MistyWest/VR-Gantry-Mechanical/README.md

# MECHANICAL - HTC Vive Gantry #





SolidWork 2015 design files for the VR Gantry project.

The repository is moved to https://bitbucket.org/mw_active/vr-gantry-mechanical
