MistyWest/VR-Gantry-Mechanical/RevD/MW05 BOM RevD.xlsx

Sheet: Sheet1
ITEM NO. | PART NUMBER | DESCRIPTION | FILE / CONF NAME | EXPAND | SUPPLIER | SUPPLIER PN | SUPPLIER MOQ | UNITS | SUPPLIER PRICE | QTY. | INCLUDED IN DRAWING | SUPPLIER LEAD TIME | QTY TO ORDER | TOTAL COST
1 | MW-MW05-C001 |  | MW-MW05-C001 | CONSTRUCTION |  |  |  |  |  | 1
3 | MW-MW05-P009 | Y GANTRY WHEEL BRACKET | MW-MW05-P009 | BUILD |  |  |  |  |  | 2 | x |  | 2 | $0.00
4 | MW-MW05-P010 | Y GANTRY TOP PLATE W/ CABLE MOUNT | MW-MW05-P010 | BUILD |  |  |  |  |  | 1 | x |  | 1 | $0.00
8 | MW-MW05-P015 | Y GANTRY FRAMING BRACKET | MW-MW05-P015 | BUILD |  |  |  |  |  | 4 | x |  | 4 | $0.00
10 | MW-MW05-P022 | Y GANTRY WHEEL MOUNT RECTANGULAR WASHER | MW-MW05-P022 | BUILD |  |  |  |  |  | 4 | x |  | 4 | $0.00
11 | MW-MW05-P010 | Y GANTRY TOP PLATE | MW-MW05-P010 | BUILD |  |  |  |  |  | 1 | x |  | 1 | $0.00
13 | MW-MW05-P014 | X GANTRY WHEEL BRACKET | MW-MW05-P014 | BUILD |  |  |  |  |  | 1 | x |  | 1 | $0.00
14 | MW-MW05-P011 | X GANTRY TOP PLATE | MW-MW05-P011 | BUILD |  |  |  |  |  | 1 | x |  | 1 | $0.00
16 | MW-MW05-P023 | X GANTRY FRAME BRACKET | MW-MW05-P023 | BUILD |  |  |  |  |  | 2 | x |  | 2 | $0.00
19 | MW-MW05-P007 | STEPPER MOTOR BRACKET | MW-MW05-P007 | BUILD |  |  |  |  |  | 2 | x |  | 2 | $0.00
20 | MW-MW05-P008 | UPPER PULLEY BRACKET | MW-MW05-P008 | BUILD |  |  |  |  |  | 2 | x |  | 2 | $0.00
29 | MW-MW05-P019 | LASER CUT SPACER | MW-MW05-P019 | BUILD |  |  |  |  |  | 2 | x |  | 2 | $0.00
31 | MW-MW05-P021 | Y CABLE GUIDE MOUNT | MW-MW05-P021 | BUILD |  |  |  |  |  | 1 | x |  | 1 | $95.00 | Price from Bombay Engraving
22 | 1254N22_MXL LIGHTWEIGHT TIMING BELT PULLEY 0.693IN OD 0.25IN WD |  | 1254N22_MXL LIGHTWEIGHT TIMING BELT PULLEY 0.693IN OD 0.25IN WD | BUY | MCMASTER-CARR | 1254N22 |  | EA | $6.50 | 8 |  |  | 8 | $52.00
27 | 1688K500_ULTRA-LOW-FRICTION OIL- EMBEDDED SLEEVE BRNG |  | 1688K5 | BUY | MCMASTER-CARR | 1688K500 |  | EA | $0.74 | 2 |  |  | 2 | $1.48
25 | 3088A464_STEEL SHIM 0.062IN THICK |  | 3088A464_STEEL SHIM 0.062IN THICK | BUY | MCMASTER-CARR | 3088A464 | 1 | PK10 | $5.05 | 6 |  |  | 1 | $5.05
18 | 4409T243_SNAP-TOGETHER CABLE AND HOSE CARRIER | Snap-Together Cable and Hose Carrier for 0.3" Maximum Cable OD/0.6" Total Cable Width, Open | 4409T243 | BUY | MCMASTER-CARR | 4409T243 | 1, 3, 6 FT | PER FT | $15.98 | 2 |  |  | 12 | $191.76
9 | 4556T340_MOUNTING BRACKET | Mounting Brackets for 0.6" High x 1.1" Wide Open Snap-Together Cable and Hose Carrier | 4556T340_MOUNTING BRACKET | BUY | MCMASTER-CARR | 4556T340 |  | PK2 | $9.21 | 4 |  |  | 2 | $18.42
17 | 47065T236_ALUMINUM T-SLOTTED FRAMING EXTRUSION | Bracket, 1" Long for 1" High Single Profile Aluminum T-Slotted Framing Extrusion | 47065T236 | BUY | MCMASTER-CARR | 47065T236 |  | EA | $5.79 | 4 |  |  | 4 | $23.16
36 | 47065T239_ALUMINUM T-SLOTTED FRAMING EXTRUSION | Bracket, 2" Long for 1" High Single Profile Aluminum T-Slotted Framing Extrusion | 47065T239 | BUY | MCMASTER-CARR | 47065T239 |  | EA | $5.85 | 4 |  |  | 4 | $23.40
21 | 47065T970_ALUMINUM T-SLOTTED FRAMING EXTRUSION | Steel End-Feed Fastener for 1-1/2" Single/3" Quad Aluminum T-Slotted Framing Extrusion | 47065T97 | BUY | MCMASTER-CARR | 47065T970 |  | PK4 | $2.71 | 27 |  |  | 9 | $24.39
32 | 7959K21_MXL TIMING BELT | 1/4" Width Mxl Series Timing Belt | 7959K21_MXL TIMING BELT | BUY | MCMASTER-CARR | 7959K21 |  | PER FT | $2.16 | 1 |  |  | 48 | $103.68
26 | 90633A011_LOW-STRENGTH STEEL THIN NYLON- INSERT LOCKNUT |  | 90633A011 | BUY | MCMASTER-CARR | 90633A011 |  | PK100 | $3.14 | 8 |  |  | 1 | $3.14
5 | 91290A164_BLACK-OXIDE CLASS 12.9 SHCS M4x16MM | Black-Oxide Class 12.9 Socket Head Cap Screw, Alloy Steel, M4 Thread, 18mm Length, 0.70mm Pitch | 91290A150 | BUY | MCMASTER-CARR | 91290A164 |  | PK100 | $10.98 | 26 |  |  | 1 | $10.98
24 | 92510A483_ALUM UNTHRD SPACER | 5/8" OD, 1/8" Length, for 1/4" Screw Size | 92510A483 | BUY | MCMASTER-CARR | 92510A483 |  | EA | $1.71 | 18 |  |  | 1 | $1.71
28 | 93268A501_BRASS SHIM 0.001IN |  | 93268A501_BRASS SHIM 0.001IN | BUY | MCMASTER-CARR | 93268A501 |  | PK10 | $8.64 | 4 |  |  | 1 | $8.64
23 | 94035A578_TIGHT-TOLERANCE SOCKET DRIVE SHOULDER SCREW |  | 94035A578 | BUY | MCMASTER-CARR | 94035A578 | 5 | EA | $4.57 | 8 |  |  | 8 | $36.56
6 | 96887A329_CLASS 5 STEEL SQUARE NUT | Class 5 Steel Square Nut, Zinc Plated, M4x0.7 Thread Size, 7mm Wide, 3.2mm High | 96887A329 | BUY | MCMASTER-CARR | 96887A329 |  | PK100 | $10.00 | 26 |  |  | 1 | $10.00
15 | 9904K100_TRACK ROLLER CARRIAGE FOR T- SLOTTED FRAMING | Track Roller Carriage for T-Slotted Framing for 1/4" Width T-Slot, 1" High Rail | 9904K1 | BUY | MCMASTER-CARR | 9904K100 |  | EA | $56.67 | 6 |  |  | 6 | $340.02
12 | MW-MW05-P006 | Aluminum T-Slotted Framing Extrusion, Single Profile, 1" Size, Solid, 4' Long | MW-MW05-P006 | BUY | MCMASTER-CARR | 47065T122 |  | EA | $19.79 | 5 |  |  | 5 | $98.95
34 | PP-ARDUINO |  |  | BUY |  |  |  | EA | $20.00 | 1 |  | http://openbuildspartstore.com/cnc-xpro-v2- controller-stepper-driver/ | 1 | $20.00
33 | PP-MICRO LIMIT SWITCH | Micro Limit Switch Kit with Mounting Plate | PP-MICRO LIMIT SWITCH | BUY | OPENBUILDS | SKU 745 |  | EA | $2.50 | 4 |  | http://openbuildspartstore.com/micro-limit- switch-kit-with-mounting-plate/ | 4 | $10.00
30 | PP-NEMA 23 | NEMA 23 Shaft Size: 1/4" Torque: 175 oz-in 2.8A 12-48V 4-wire Bipolar | Nema 23 Stepper Motor | BUY | OPENBUILDS | SKU518 |  | EA | $31.92 | 2 |  | http://openbuildspartstore.com/nema-23- stepper-motor/ | 2 | $63.84
36 | PP-STEPPER DRIVER |  |  | BUY | OPENBUILDS |  |  | EA | $52.00 | 2 |  |  | 2 | $104.00
35 | PP-TIMING BELT TORSION SPRING | Timing Belt Tension Torsion Spring | PP-TIMING BELT TORSION SPRING | BUY | OPENBUILDS | SKU 75 |  | EA | $1.04 | 4 |  | http://openbuildspartstore.com/timing-belt- tension-torsion-spring/ | 4 | $4.16
 |  |  |  |  |  |  |  |  |  |  |  |  | TOTAL | $1250.34

Sheet: Sheet2
SUPPLIER PN | QTY TO ORDER
1254N22 | 8
1688K500 | 2
3088A464 | 1
4409T243 | 12
4556T340 | 2
47065T236 | 4
47065T239 | 4
47065T970 | 9
7959K21 | 35
90633A011 | 1
91290A164 | 1
92510A483 | 1
93268A501 | 1
94035A578 | 8
96887A329 | 1
9904K100 | 2
9904K300 | 4
47065T146 | 4
47065T121 | 1
8505K92 | 1
SKU 885 | 1
SKU 745 | 4
SKU518 | 2
SKU 75 | 4
