MistyWest/VR-Gantry-Mechanical/RevD/MW-MW05-A008.SLDASM

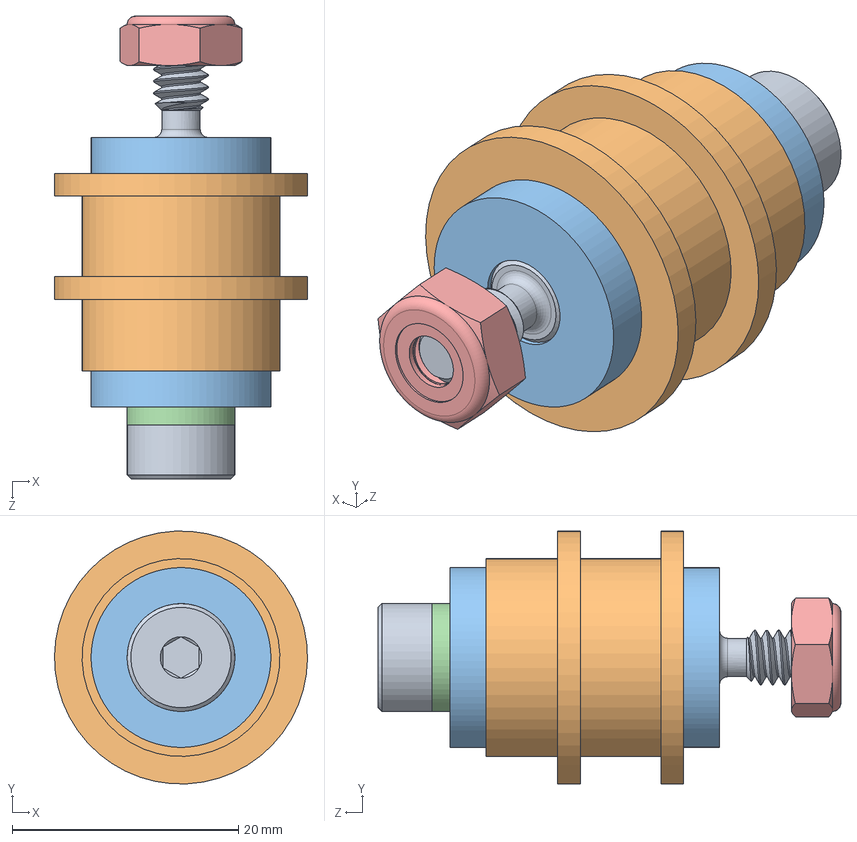
[picture p1: CAD file, 2017-03-31]
RevD/MW-MW05-A008.SLDASM
22.4 x 22.3 x 40.9 mm
94035A578_TIGHT-TOLERANCE SOCKET DRIVE SHOULDER SCREW
1254N22_MXL LIGHTWEIGHT TIMING BELT PULLEY 0.693IN OD 0.25IN WD
92510A483_ALUM UNTHRD SPACER x 2
3088A464_STEEL SHIM 0.062IN THICK
90633A011_LOW-STRENGTH STEEL THIN NYLON-INSERT LOCKNUT
