MistyWest/VR-Gantry-Mechanical/RevD/MW-MW05-A005.SLDASM

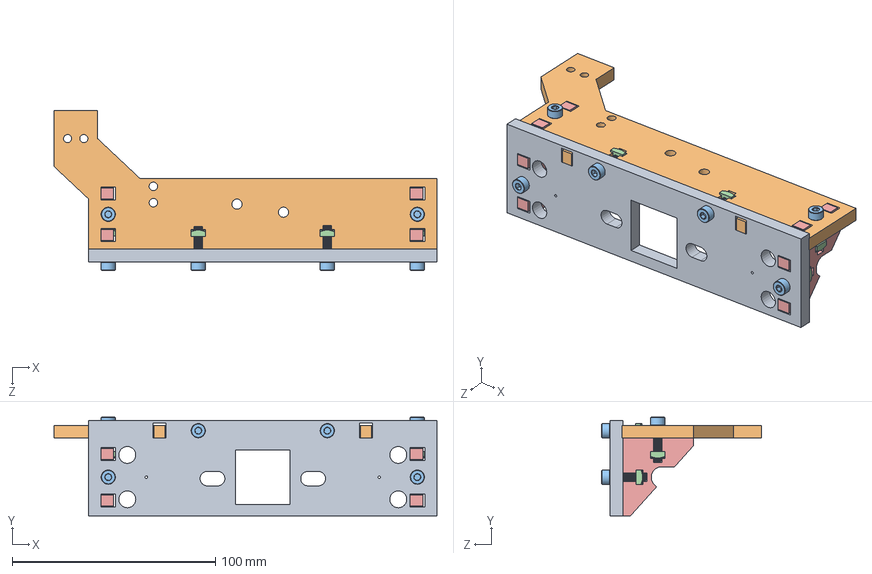
[picture p2: CAD file, 2017-03-31]
RevD/MW-MW05-A005.SLDASM
188.5 x 48.6 x 78.5 mm
MW-MW05-P009
MW-MW05-P010
91290A154_BLACK-OXIDE CLASS 12.9 SHCS M4x16MM x 6
96887A329_CLASS 5 STEEL SQUARE NUT x 6
MW-MW05-P015 x 2
