MistyWest/VR-Gantry-Mechanical/RevD/MW-MW05-A006.SLDASM

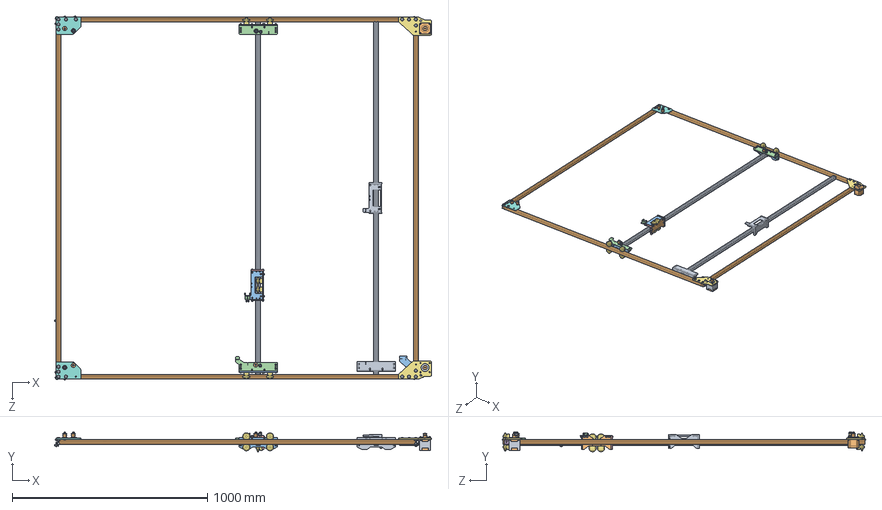
[picture p3: CAD file, 2017-03-31]
RevD/MW-MW05-A006.SLDASM
1929.8 x 100.5 x 1862.8 mm
MW-MW05-P005
MW-MW05-P009 x 2
MW-MW05-P010 x 2
91290A154_BLACK-OXIDE CLASS 12.9 SHCS M4x16MM x 26
96887A329_CLASS 5 STEEL SQUARE NUT x 26
9904K100_TRACK ROLLER CARRIAGE FOR T-SLOTTED FRAMING x 6
MW-MW05-P015 x 4
MW-MW05-P006
MW-MW05-P014
MW-MW05-P011
MW-MW05-P023 x 2
47065T236_ALUMINUM T-SLOTTED FRAMING EXTRUSION x 4
MW-MW05-P007 x 2
MW-MW05-P008 x 2
47065T970_ALUMINUM T-SLOTTED FRAMING EXTRUSION x 20
1254N22_MXL LIGHTWEIGHT TIMING BELT PULLEY 0.693IN OD 0.25IN WD x 8
94035A578_TIGHT-TOLERANCE SOCKET DRIVE SHOULDER SCREW x 8
92510A483_ALUM UNTHRD SPACER x 18
3088A464_STEEL SHIM 0.062IN THICK x 6
90633A011_LOW-STRENGTH STEEL THIN NYLON-INSERT LOCKNUT x 7
1688K500_ULTRA-LOW-FRICTION OIL-EMBEDDED SLEEVE BRNG x 2
93268A501_BRASS SHIM 0.001IN x 4
MW-MW05-P019 x 2
Nema 23 Stepper Motor x 2
MW-MW05-P021
47065T139_ALUMINUM T-SLOTTED FRAMING EXTRUSION x 3
97763A265_BLACK-OXIDE 18-8 SS BUTTON-HEAD CAP SCREW x 5
90494A029_LOW-STRENGTH STEEL THIN HEX NUT
