MistyWest/VR-Gantry-Mechanical/RevD/MW-MW05-A009.SLDASM

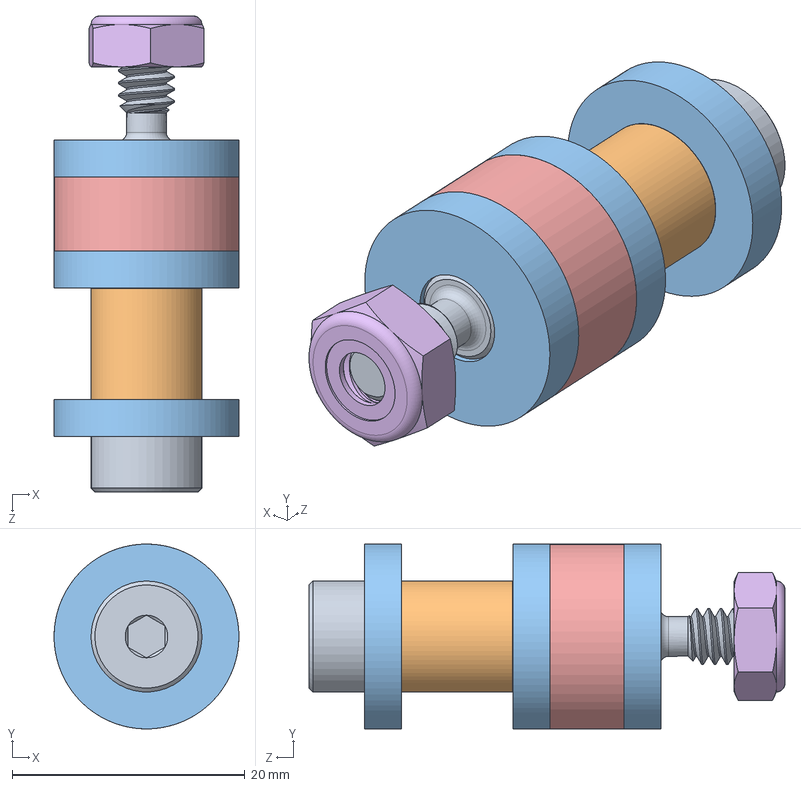
[picture p4: CAD file, 2017-03-31]
RevD/MW-MW05-A009.SLDASM
15.9 x 15.9 x 40.9 mm
94035A578_TIGHT-TOLERANCE SOCKET DRIVE SHOULDER SCREW
1688K500_ULTRA-LOW-FRICTION OIL-EMBEDDED SLEEVE BRNG
92510A483_ALUM UNTHRD SPACER x 3
93268A501_BRASS SHIM 0.001IN x 2
MW-MW05-P019
90633A011_LOW-STRENGTH STEEL THIN NYLON-INSERT LOCKNUT
