MistyWest/VR-Gantry-Mechanical/RevD/MW-MW05-A007.SLDASM

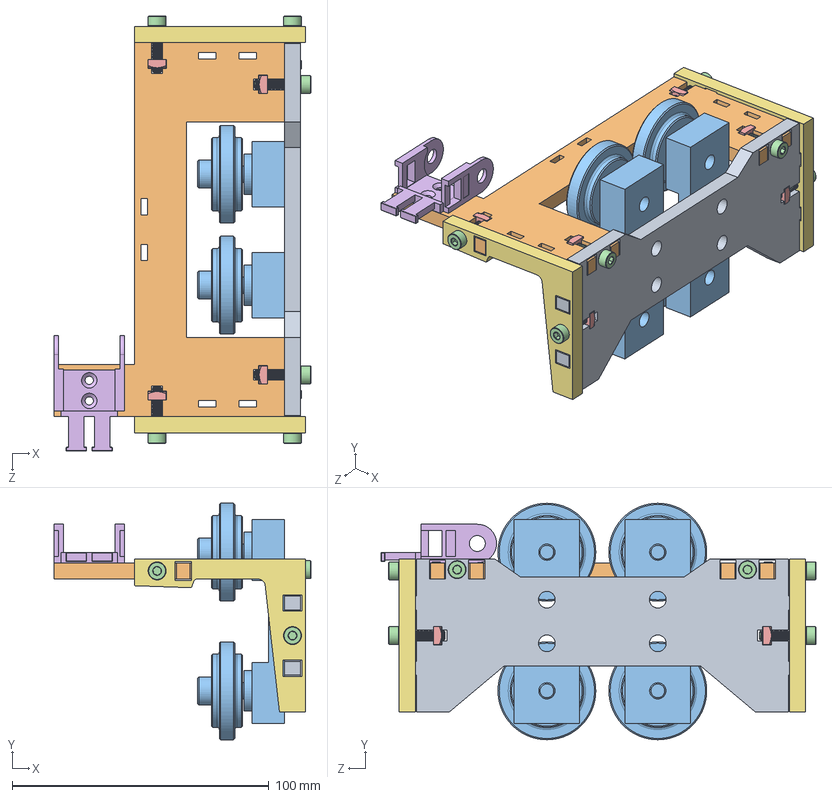
[picture p5: CAD file, 2017-03-31]
RevD/MW-MW05-A007.SLDASM
100.0 x 92.1 x 169.3 mm
MW-MW05-P014
MW-MW05-P011
9904K100_TRACK ROLLER CARRIAGE FOR T-SLOTTED FRAMING x 2
91290A154_BLACK-OXIDE CLASS 12.9 SHCS M4x16MM x 6
96887A329_CLASS 5 STEEL SQUARE NUT x 6
4556T340_MOUNTING BRACKET
MW-MW05-P023 x 2
