MistyWest/VR-Gantry-Mechanical/RevD/MW-MW05-P010.SLDPRT

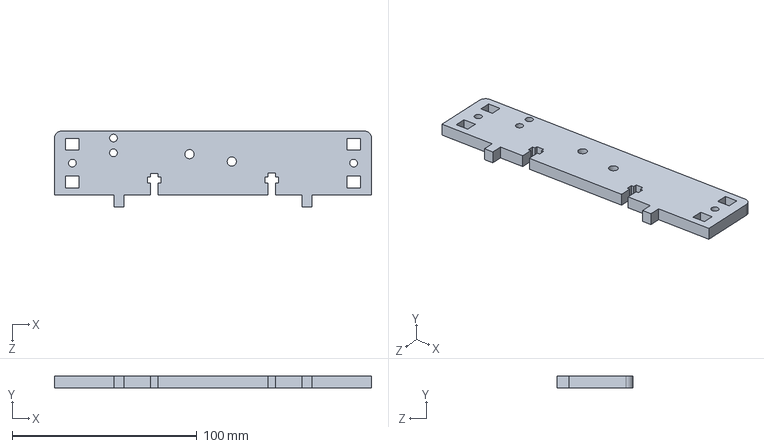
[picture p6: CAD file, 2017-03-31]
RevD/MW-MW05-P010.SLDPRT
171.5 x 6.35 x 41.1 mm
