MistyWest/VR-Gantry-Mechanical/RevD/MW-MW05-C001.SLDPRT

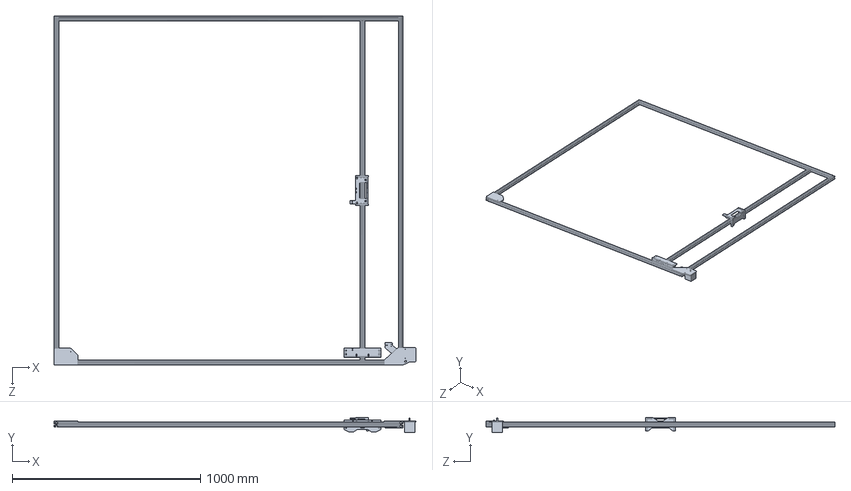
[picture p7: CAD file, 2017-03-31]
RevD/MW-MW05-C001.SLDPRT
1921.8 x 81.4 x 1854.2 mm
