MistyWest/VR-Gantry-Mechanical/RevD/MW-MW05-P007.SLDPRT

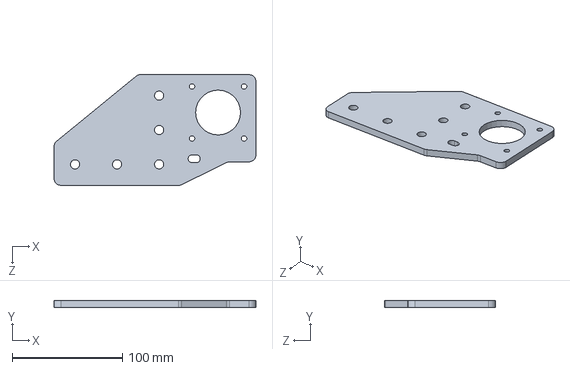
[picture p8: CAD file, 2017-03-31]
RevD/MW-MW05-P007.SLDPRT
183.0 x 6.35 x 100.4 mm
