MistyWest/VR-Gantry-Mechanical/RevD/MW-MW05-P008.SLDPRT

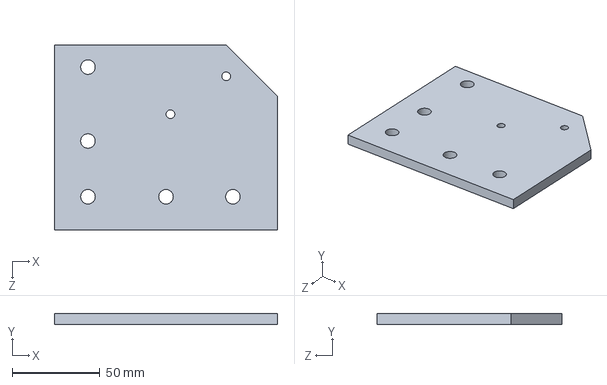
[picture p9: CAD file, 2017-03-31]
RevD/MW-MW05-P008.SLDPRT
127.0 x 6.35 x 105.6 mm
