MistyWest/VR-Gantry-Mechanical/RevD/MW-MW05-P019.SLDPRT

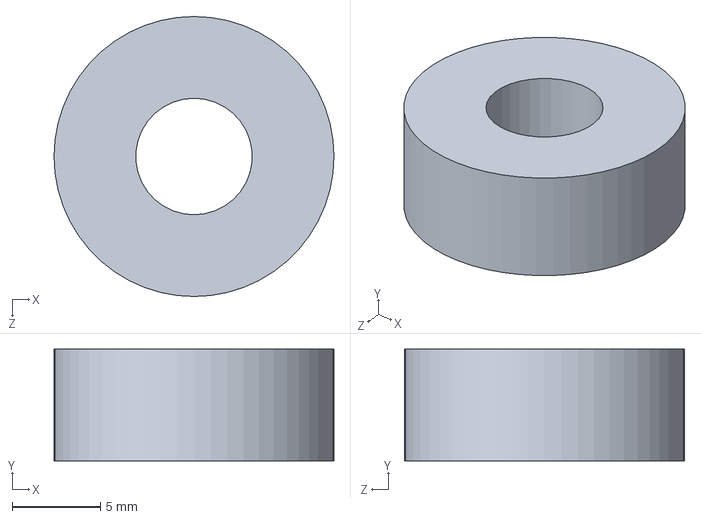
[picture p10: CAD file, 2017-03-31]
RevD/MW-MW05-P019.SLDPRT
15.9 x 6.35 x 15.9 mm
