MistyWest/VR-Gantry-Mechanical/RevD/MW-MW05-P015.SLDPRT

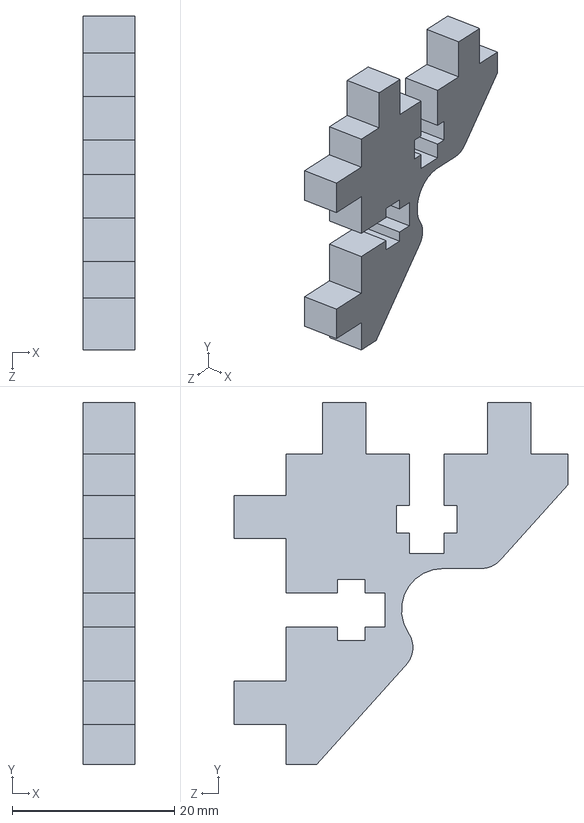
[picture p11: CAD file, 2017-03-31]
RevD/MW-MW05-P015.SLDPRT
6.35 x 44.6 x 41.1 mm
