MistyWest/VR-Gantry-Mechanical/RevD/2016.08.11_MW-MW05 Laser Cutouts.DXF

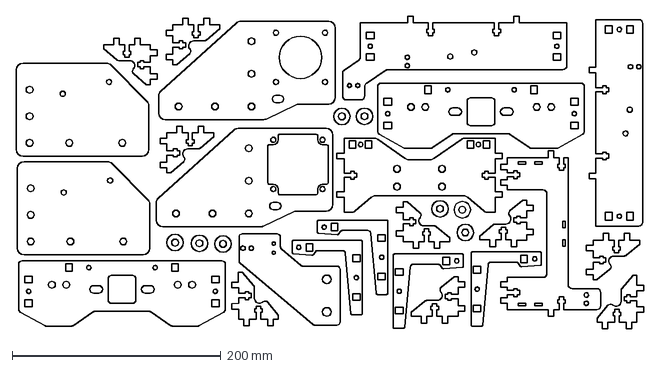
[picture p12: CAD file, 2017-03-31]
RevD/2016.08.11_MW-MW05 Laser Cutouts.DXF
601.5 x 299.8 mm
