MistyWest/VR-Gantry-Mechanical/RevD/MW-MW05-P009.SLDPRT

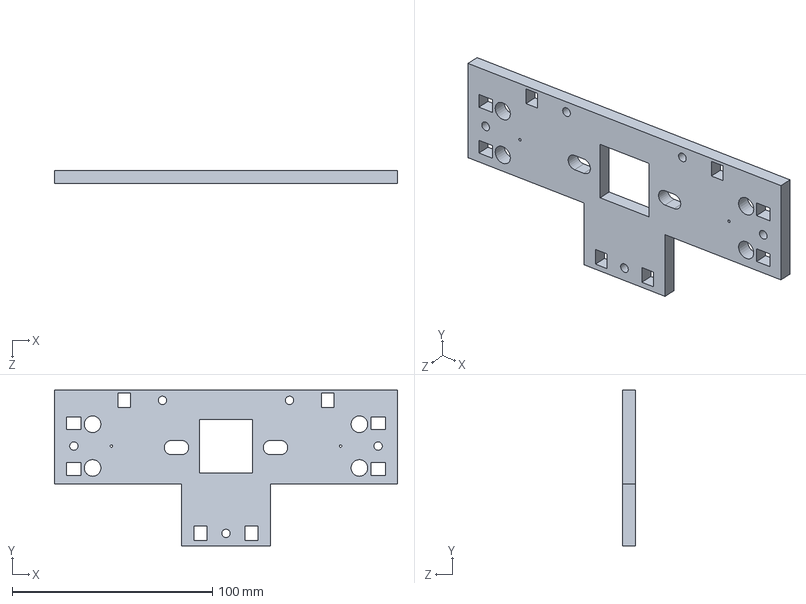
[picture p13: CAD file, 2017-03-31]
RevD/MW-MW05-P009.SLDPRT
171.4 x 77.8 x 6.35 mm
