MistyWest/VR-Gantry-Mechanical/RevD/MW-MW05-P021.SLDPRT

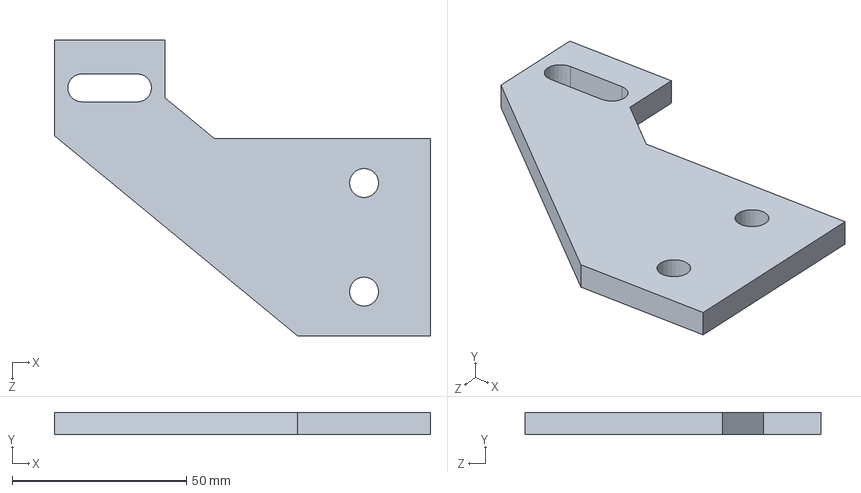
[picture p14: CAD file, 2017-03-31]
RevD/MW-MW05-P021.SLDPRT
107.8 x 6.35 x 84.8 mm
