MistyWest/VR-Gantry-Mechanical/RevD/MW-MW05-P005.SLDPRT

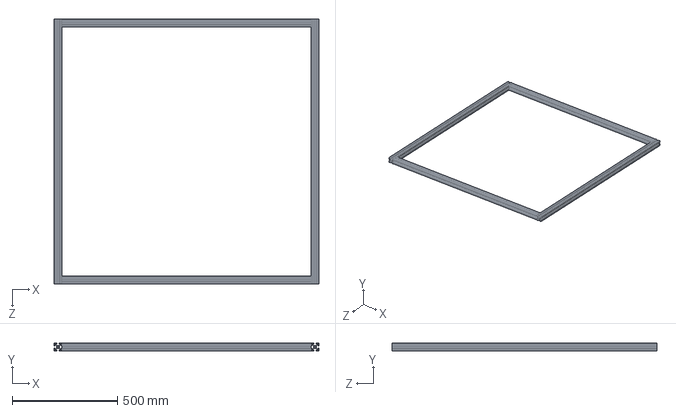
[picture p15: CAD file, 2017-03-31]
RevD/MW-MW05-P005.SLDPRT
1257.3 x 38.1 x 1257.3 mm
