MistyWest/VR-Gantry-Mechanical/RevD/MW-MW05-P011.SLDPRT

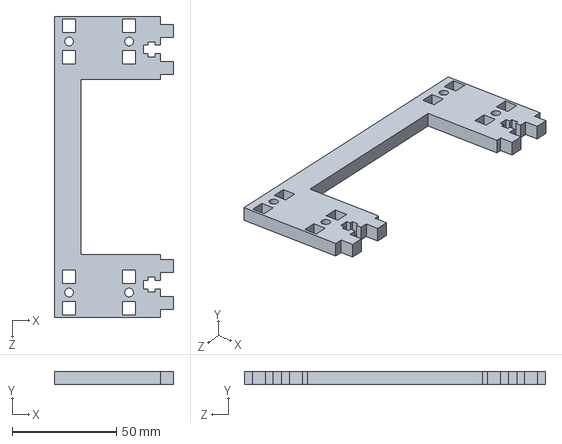
[picture p16: CAD file, 2017-03-31]
RevD/MW-MW05-P011.SLDPRT
57.2 x 6.35 x 144.8 mm
