MistyWest/VR-Gantry-Mechanical/RevD/MW-MW05-P022.SLDPRT

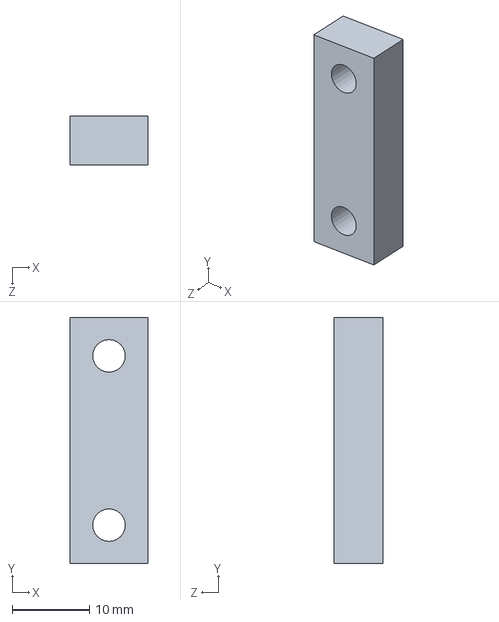
[picture p17: CAD file, 2017-03-31]
RevD/MW-MW05-P022.SLDPRT
10.1 x 31.8 x 6.35 mm
