MistyWest/VR-Gantry-Mechanical/RevD/Nema 23 Stepper Motor.SLDPRT

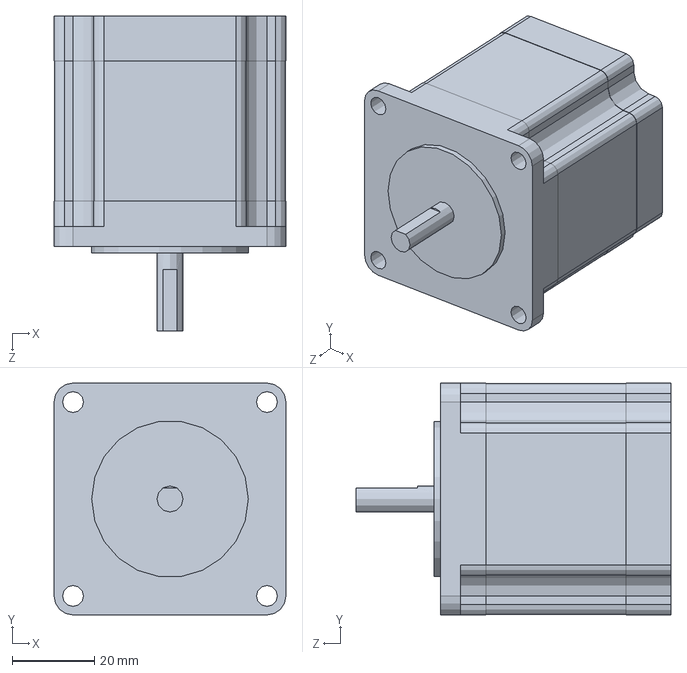
[picture p18: CAD file, 2017-03-31]
RevD/Nema 23 Stepper Motor.SLDPRT
56.4 x 56.4 x 76.6 mm
