MistyWest/VR-Gantry-Mechanical/RevD/MW-MW05-P006.SLDPRT

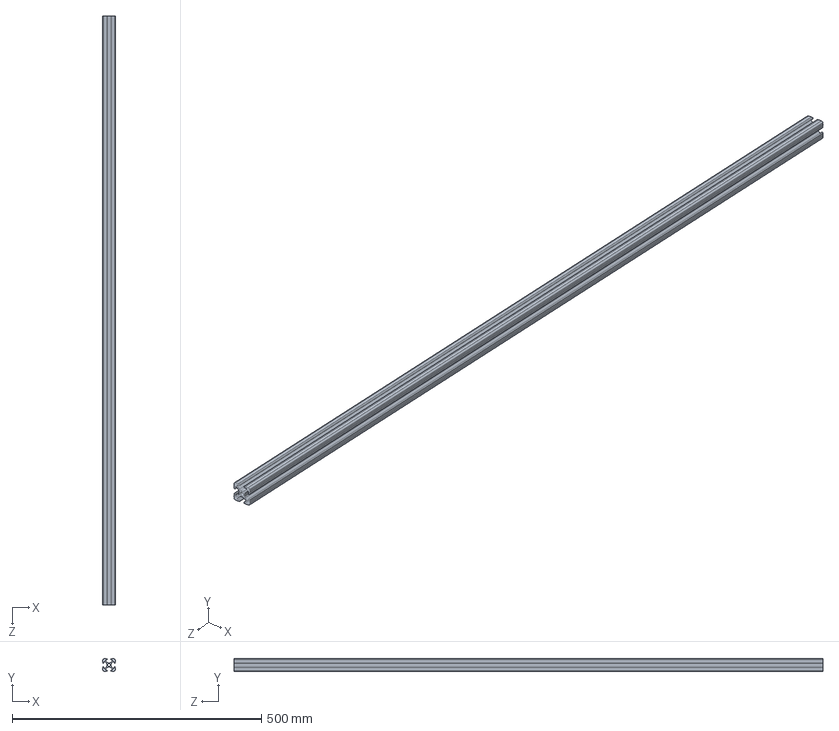
[picture p19: CAD file, 2017-03-31]
RevD/MW-MW05-P006.SLDPRT
25.4 x 25.4 x 1181.1 mm
