MistyWest/VR-Gantry-Mechanical/RevD/MW-MW05-P014.SLDPRT

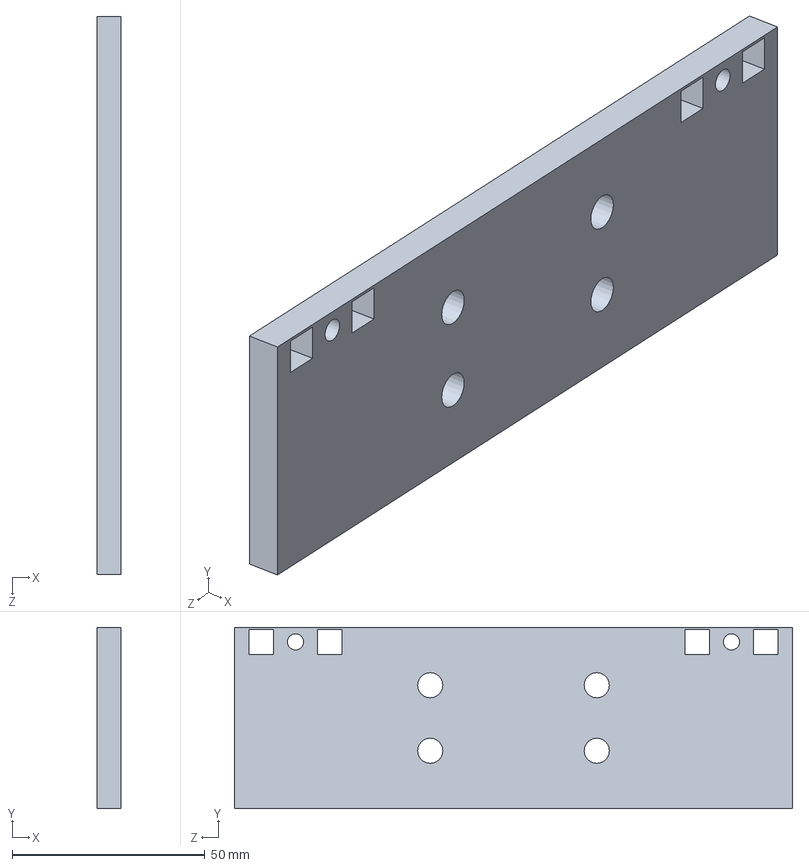
[picture p20: CAD file, 2017-03-31]
RevD/MW-MW05-P014.SLDPRT
6.35 x 46.9 x 144.8 mm
