MistyWest/VR-Gantry-Mechanical/RevD/MW-MW05-P023.SLDPRT

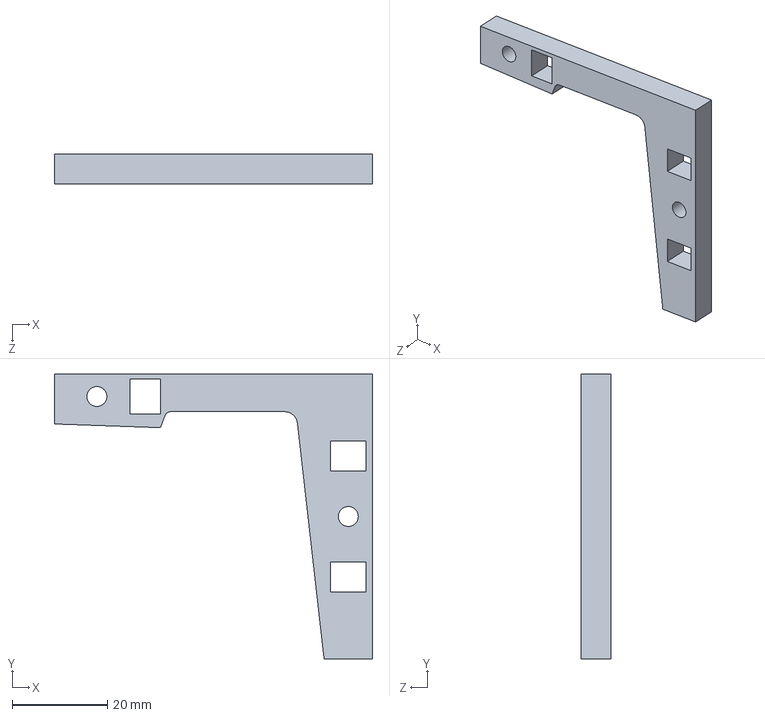
[picture p21: CAD file, 2017-03-31]
RevD/MW-MW05-P023.SLDPRT
66.7 x 59.7 x 6.35 mm
