MistyWest/VR-Gantry-Mechanical/(list of files, cad)

Other CAD files:
RevD/PP-CNC XPRO CONTROLLER STEPPER DRIVER.SLDPRT
RevD/PP-ACRYLIC SHEET 12X24IN.SLDPRT
RevD/PP-TIMING BELT TORSION SPRING.SLDPRT
RevD/PP-MICRO LIMIT SWITCH.SLDPRT
Archive/Human Reference/Calf.SLDPRT
Archive/Human Reference/Chest.SLDPRT
Archive/Human Reference/Foot.SLDPRT
Archive/Human Reference/Hand.SLDPRT
Archive/Human Reference/Head.SLDPRT
Archive/Human Reference/Human Body Model - Simple.SLDASM
Archive/Human Reference/LowerArm.SLDPRT
Archive/Human Reference/Thigh.SLDPRT
Archive/Human Reference/UpperArm.SLDPRT
Archive/Human Reference/neck.SLDPRT
Archive/Rev0/1254N22_MXL LIGHTWEIGHT TIMING BELT PULLEY 0.693IN OD 0.25IN WD.SLDPRT
Archive/Rev0/47065T236_ALUMINUM T-SLOTTED FRAMING EXTRUSION.SLDPRT
Archive/Rev0/47065T239_ALUMINUM T-SLOTTED FRAMING EXTRUSION.SLDPRT
Archive/Rev0/47065T970_ALUMINUM T-SLOTTED FRAMING EXTRUSION.SLDPRT
Archive/Rev0/60585K810_LINEAR BEARING FOR T-SLOTTED FRAMING.SLDPRT
Archive/Rev0/91290A154_BLACK-OXIDE CLASS 12.9 SHCS M4x16MM.SLDPRT
Archive/Rev0/93268A501_BRASS SHIM 0.001IN.SLDPRT
Archive/Rev0/96887A329_CLASS 5 STEEL SQUARE NUT.SLDPRT
Archive/Rev0/9904K100_TRACK ROLLER CARRIAGE FOR T-SLOTTED FRAMING.SLDPRT
Archive/Rev0/9904K300_TRACK ROLLER CARRIAGE FOR T-SLOTTED FRAMING.SLDPRT
Archive/Rev0/Assem3.SLDASM
Archive/Rev0/MW-MW05-A001.SLDASM
Archive/Rev0/MW-MW05-A002.SLDASM
Archive/Rev0/MW-MW05-A003.SLDASM
Archive/Rev0/MW-MW05-A004.SLDASM
Archive/Rev0/MW-MW05-A005.SLDASM
Archive/Rev0/MW-MW05-A006.SLDASM
Archive/Rev0/MW-MW05-A007.SLDASM
Archive/Rev0/MW-MW05-A008.SLDASM
Archive/Rev0/MW-MW05-A009.SLDASM
Archive/Rev0/MW-MW05-C001.SLDPRT
Archive/Rev0/MW-MW05-P001.SLDPRT
Archive/Rev0/MW-MW05-P002.SLDPRT
Archive/Rev0/MW-MW05-P003.SLDPRT
Archive/Rev0/MW-MW05-P004.SLDPRT
Archive/Rev0/MW-MW05-P005.SLDPRT
Archive/Rev0/MW-MW05-P006.SLDPRT
Archive/Rev0/MW-MW05-P007.SLDPRT
Archive/Rev0/MW-MW05-P008.SLDPRT
Archive/Rev0/MW-MW05-P009.SLDPRT
Archive/Rev0/MW-MW05-P010.SLDPRT
Archive/Rev0/MW-MW05-P011.SLDPRT
Archive/Rev0/MW-MW05-P012.SLDPRT
Archive/Rev0/MW-MW05-P013.SLDPRT
Archive/Rev0/MW-MW05-P014.SLDPRT
Archive/Rev0/MW-MW05-P015.SLDPRT
Archive/Rev0/MW-MW05-P016.SLDPRT
Archive/Rev0/MW-MW05-P017.SLDPRT
Archive/Rev0/MW-MW05-P018.SLDPRT
Archive/Rev0/MW-MW05-P019.SLDPRT
Archive/Rev0/NEMA23.SLDPRT
Archive/Rev0/Nema 23 Stepper Motor.SLDPRT
Archive/Rev0/PP-NEMA 23 STEPPER MOTOR.SLDPRT
Archive/Rev0/Play Area Layout.SLDPRT
Archive/Stepper Motor/Base.SLDPRT
Archive/Stepper Motor/Cuerpo.SLDPRT
Archive/Stepper Motor/Eje.SLDPRT
Archive/Stepper Motor/NEMA 17 with T5 Pulley.SLDASM
Archive/Stepper Motor/NEMA 17 with T5 Pulley.STEP
Archive/Stepper Motor/NEMA 17 with T5 Pulley.STP
Archive/Stepper Motor/NEMA 17.SLDASM
Archive/Stepper Motor/NEMA 17.STL
Archive/Stepper Motor/Tapa.SLDPRT
RevA/1254N22_MXL LIGHTWEIGHT TIMING BELT PULLEY 0.693IN OD 0.25IN WD.SLDPRT
RevA/1688K500_ULTRA-LOW-FRICTION OIL-EMBEDDED SLEEVE BRNG.SLDPRT
RevA/3088A464_STEEL SHIM 0.062IN THICK.SLDPRT
RevA/4409T243_SNAP-TOGETHER CABLE AND HOSE CARRIER.SLDPRT
RevA/4556T340_MOUNTING BRACKET.SLDPRT
RevA/47065T236_ALUMINUM T-SLOTTED FRAMING EXTRUSION.SLDPRT
RevA/47065T970_ALUMINUM T-SLOTTED FRAMING EXTRUSION.SLDPRT
RevA/7959K21_MXL TIMING BELT.SLDPRT
RevA/90633A011_LOW-STRENGTH STEEL THIN NYLON-INSERT LOCKNUT.SLDPRT
RevA/91290A154_BLACK-OXIDE CLASS 12.9 SHCS M4x16MM.SLDPRT
RevA/92137A303_CLASS 10.9 ALLOY STEEL BUTTON-HEAD CAP SCREW.SLDPRT
RevA/92141A011_TYPE 18-8 STAINLESS STEEL FLAT WASHER.SLDPRT
RevA/92235A114_FLANGED ALLOY SOCKET CAP SCREW.SLDPRT
RevA/92510A483_ALUM UNTHRD SPACER.SLDPRT
RevA/93268A501_BRASS SHIM 0.001IN.SLDPRT
RevA/94035A578_TIGHT-TOLERANCE SOCKET DRIVE SHOULDER SCREW.SLDPRT
RevA/96887A329_CLASS 5 STEEL SQUARE NUT.SLDPRT
RevA/9904K100_TRACK ROLLER CARRIAGE FOR T-SLOTTED FRAMING.SLDPRT
RevA/9904K300_TRACK ROLLER CARRIAGE FOR T-SLOTTED FRAMING.SLDPRT
RevA/MW-MW05-A005.SLDASM
RevA/MW-MW05-A006.SLDASM
RevA/MW-MW05-A007.SLDASM
RevA/MW-MW05-A008.SLDASM
RevA/MW-MW05-A009.SLDASM
RevA/MW-MW05-C001.SLDPRT
RevA/MW-MW05-P005.SLDPRT
RevA/MW-MW05-P006.SLDPRT
RevA/MW-MW05-P007.SLDPRT
RevA/MW-MW05-P008.SLDPRT
RevA/MW-MW05-P009.SLDPRT
RevA/MW-MW05-P010.SLDPRT
RevA/MW-MW05-P011.SLDPRT
RevA/MW-MW05-P012.SLDPRT
RevA/MW-MW05-P013.SLDPRT
RevA/MW-MW05-P014.SLDPRT
RevA/MW-MW05-P015.SLDPRT
RevA/MW-MW05-P016.SLDPRT
RevA/MW-MW05-P017.SLDPRT
RevA/MW-MW05-P018.SLDPRT
RevA/MW-MW05-P020.SLDPRT
RevA/MW-MW05-P021.SLDPRT
RevA/MW-MW05-P022.SLDPRT
RevA/NEMA23.SLDPRT
RevA/PP-CNC XPRO CONTROLLER STEPPER DRIVER.SLDPRT
RevA/PP-MICRO LIMIT SWITCH.SLDPRT
RevA/PP-TIMING BELT TORSION SPRING.SLDPRT
RevB/MW05-A001_B.SLDASM
RevC/1254N22_MXL LIGHTWEIGHT TIMING BELT PULLEY 0.693IN OD 0.25IN WD.SLDPRT
RevC/1688K500_ULTRA-LOW-FRICTION OIL-EMBEDDED SLEEVE BRNG.SLDPRT
RevC/3088A464_STEEL SHIM 0.062IN THICK.SLDPRT
RevC/4409T243_SNAP-TOGETHER CABLE AND HOSE CARRIER.SLDPRT
RevC/4556T340_MOUNTING BRACKET.SLDPRT
RevC/47065T139_ALUMINUM T-SLOTTED FRAMING EXTRUSION.SLDPRT
RevC/47065T236_ALUMINUM T-SLOTTED FRAMING EXTRUSION.SLDPRT
RevC/47065T239_ALUMINUM T-SLOTTED FRAMING EXTRUSION (1).SLDPRT
RevC/47065T970_ALUMINUM T-SLOTTED FRAMING EXTRUSION.SLDPRT
RevC/7959K21_MXL TIMING BELT.SLDPRT
RevC/90633A011_LOW-STRENGTH STEEL THIN NYLON-INSERT LOCKNUT.SLDPRT
RevC/91290A154_BLACK-OXIDE CLASS 12.9 SHCS M4x16MM.SLDPRT
RevC/92510A483_ALUM UNTHRD SPACER.SLDPRT
RevC/93268A501_BRASS SHIM 0.001IN.SLDPRT
RevC/94035A578_TIGHT-TOLERANCE SOCKET DRIVE SHOULDER SCREW.SLDPRT
RevC/96887A329_CLASS 5 STEEL SQUARE NUT.SLDPRT
RevC/97763A265_BLACK-OXIDE 18-8 SS BUTTON-HEAD CAP SCREW.SLDPRT
RevC/9904K100_TRACK ROLLER CARRIAGE FOR T-SLOTTED FRAMING.SLDPRT
RevC/9904K300_TRACK ROLLER CARRIAGE FOR T-SLOTTED FRAMING.SLDPRT
RevC/MW-MW05 Laser Cutouts.SLDDRW
RevC/MW-MW05-A005.SLDASM
RevC/MW-MW05-A007.SLDASM
RevC/MW-MW05-A008.SLDASM
RevC/MW-MW05-A009.SLDASM
RevC/MW-MW05-C001.SLDPRT
RevC/MW-MW05-P005.SLDPRT
RevC/MW-MW05-P006.SLDPRT
RevC/MW-MW05-P007.SLDPRT
RevC/MW-MW05-P008.SLDPRT
RevC/MW-MW05-P009.SLDPRT
RevC/MW-MW05-P010.SLDPRT
RevC/MW-MW05-P011.SLDPRT
RevC/MW-MW05-P014.SLDPRT
RevC/MW-MW05-P015.SLDPRT
RevC/MW-MW05-P016.SLDPRT
RevC/MW-MW05-P021.SLDPRT
RevC/MW-MW05-P022.SLDPRT
RevC/MW-MW05-P023.SLDPRT
RevC/PP-ACRYLIC SHEET 12X24IN.SLDPRT
RevC/PP-CNC XPRO CONTROLLER STEPPER DRIVER.SLDPRT
RevC/PP-MICRO LIMIT SWITCH.SLDPRT
RevC/PP-TIMING BELT TORSION SPRING.SLDPRT
RevC/[FOR QUOTE] MW-MW05 Laser Cutouts_Rev1.DXF
RevD/1254N22_MXL LIGHTWEIGHT TIMING BELT PULLEY 0.693IN OD 0.25IN WD.SLDPRT
RevD/1688K500_ULTRA-LOW-FRICTION OIL-EMBEDDED SLEEVE BRNG.SLDPRT
RevD/3088A464_STEEL SHIM 0.062IN THICK.SLDPRT
RevD/4409T243_SNAP-TOGETHER CABLE AND HOSE CARRIER.SLDPRT
RevD/4556T340_MOUNTING BRACKET.SLDPRT
RevD/47065T139_ALUMINUM T-SLOTTED FRAMING EXTRUSION.SLDPRT
RevD/47065T236_ALUMINUM T-SLOTTED FRAMING EXTRUSION.SLDPRT
RevD/47065T239_ALUMINUM T-SLOTTED FRAMING EXTRUSION (1).SLDPRT
RevD/47065T970_ALUMINUM T-SLOTTED FRAMING EXTRUSION.SLDPRT
RevD/7959K21_MXL TIMING BELT.SLDPRT
RevD/90494A029_LOW-STRENGTH STEEL THIN HEX NUT.SLDPRT
RevD/90633A011_LOW-STRENGTH STEEL THIN NYLON-INSERT LOCKNUT.SLDPRT
RevD/91290A154_BLACK-OXIDE CLASS 12.9 SHCS M4x16MM.SLDPRT
RevD/92510A483_ALUM UNTHRD SPACER.SLDPRT
RevD/93268A501_BRASS SHIM 0.001IN.SLDPRT
RevD/94035A578_TIGHT-TOLERANCE SOCKET DRIVE SHOULDER SCREW.SLDPRT
RevD/96887A329_CLASS 5 STEEL SQUARE NUT.SLDPRT
RevD/97763A265_BLACK-OXIDE 18-8 SS BUTTON-HEAD CAP SCREW.SLDPRT
RevD/9904K100_TRACK ROLLER CARRIAGE FOR T-SLOTTED FRAMING.SLDPRT
RevD/9904K300_TRACK ROLLER CARRIAGE FOR T-SLOTTED FRAMING.SLDPRT
RevD/MW-MW05 Laser Cutouts.SLDDRW
