MistyWest/VR-Gantry-Mechanical/(commit log)

2017-03-31 -Initial and probably final commit for mechanical elements of the project
    [1254N22_MXL LIGHTWEIGHT TIMING BELT PULLEY 0.693IN OD 0.25IN WD.SLDPRT, 1688K500_ULTRA-LOW-FRICTION OIL-EMBEDDED SLEEVE BRNG.SLDPRT, 2016.08.11_MW-MW05 Laser Cutouts.DXF, 3088A464_STEEL SHIM 0.062IN THICK.SLDPRT, 4409T243_SNAP-TOGETHER CABLE AND HOSE CARRIER.SLDPRT, 4556T340_MOUNTING BRACKET.SLDPRT, 47065T139_ALUMINUM T-SLOTTED FRAMING EXTRUSION.SLDPRT, 47065T236_ALUMINUM T-SLOTTED FRAMING EXTRUS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]
2017-04-04 Added link to BOM
